rohitm16/Rain-Rain_go_away/Direction_Switching_Mechanism.asc

C1: cap; 2.2µ
C2: cap; 2.2µ
R1: res; 1k
R2: res; 1k
R3: res; 1k
R4: res; 1k
V1: voltage; 5.0V
Named nets: 0, 5.0V
Switch
Normal Open
Normal Closed
Common Terminal
Switch
Normal Open
Normal Closed
Common Terminal
D Flip-Flop
D
Clk
Q
~Q
Motor Driver
.
ENA
12V
5V
GND
Input 1
Input 2
Input 3
Input 4
Out 1
Out 2
Out 3
Out 4
