rohitm16/Rain-Rain_go_away/PWM_generating.asc

A1: inv
A2: inv
A3: inv
A5: or
A6: inv
C1: cap; 0.25µ
R1: res; 1k
R2: res; 1k
Named nets: SQUARE_WAVE, 75%_Duty_Cycle, 50%_Duty_Cycle, J-K_Flip_Flop, J, K, Clk, Q, ~Q
-25%_Duty_Cycle
