rohitm16/Rain-Rain_go_away/PWM_Selector.asc

A1: and
A2: and
A3: and
A7: inv
A8: inv
A9: inv
A10: inv
U1: OP07
U2: OP07
U3: OP07
U4: OP07
V1: voltage; 2.1V
V2: voltage; 2.5V
V3: voltage; 3.0V
V4: voltage; 4.0V
V5: voltage; 6.6V
V6: voltage; 5V
V7: voltage; 12V
Named nets: 0, 2.1V, 2.5V, 3.0V, 4.0V, 6.6V, 5.0V, 12.0V
Output from Rain Detector
Relay Logic
Motor Driver
.
Relay
VCC
Signal
GND
Normal Open
Normal Closed
Common contact
100% PWM
Motor ( Wiper Mechanism )
ENA
12V
5V
GND
Input 1
Input 2
Input 3
Input 4
Out 1
Out 2
Out 3
Out 4
Relay
VCC
Signal
GRD
Normal Open
Normal Closed
Common contact
Relay
VCC
Signal
GND
Normal Open
Normal Closed
Common contact
IR sensor
Arduino
VCC
Signal
GND
Braking Mechanism
Arduino code to check for Braking Signal.
PWM Selection Logic
Relay
VCC
Signal
GND
Normal Open
Normal Closed
Common contact
Relay
VCC
Signal
GND
Normal Open
Normal Closed
Common contact
VCC
Signal
GND
Normal Open
Normal Closed
Common contact
Relay
75% PWM
50% PWM
25% PWM
Dirction Switching Mechanism
