rohitm16/Rain-Rain_go_away/Speedometer.asc

.: LED; 25%
.: LED; 50%
.: LED; 75%
.: LED; 100%
A1: inv
A2: inv
A3: inv
A4: inv
C1: cap; 3.3µ
R1: res; 1k
R2: res; 1k
R3: res; 1k
R4: res; 1k
R5: res; 10k
R6: res; 1Meg
U1: opamp2; for 25% speed of motor
U2: opamp2; for 50% speed of motor
U3: opamp2; for 75% speed of motor
U4: opamp2; for 100% speed of motor
V1: voltage; 4.5V
V2: voltage; 3.0V
V3: voltage; 2.0V
V4: voltage; 1.0V
V5: voltage; 6.6V
V6: voltage; 5.0V
Named nets: 0, 4.5V, 3.0V, 2.0V, 1.0V, 6.6V, 5.0V
SQUARE WAVE
Servo Motor
Arduino
VCC
PWM
GND
Output
A0
A1
A2
A3
